oschmidh/ShiftLight-HW/ShiftLight.kicad_pcb

## KiCad design ShiftLight.kicad_pcb (2025-11-02)

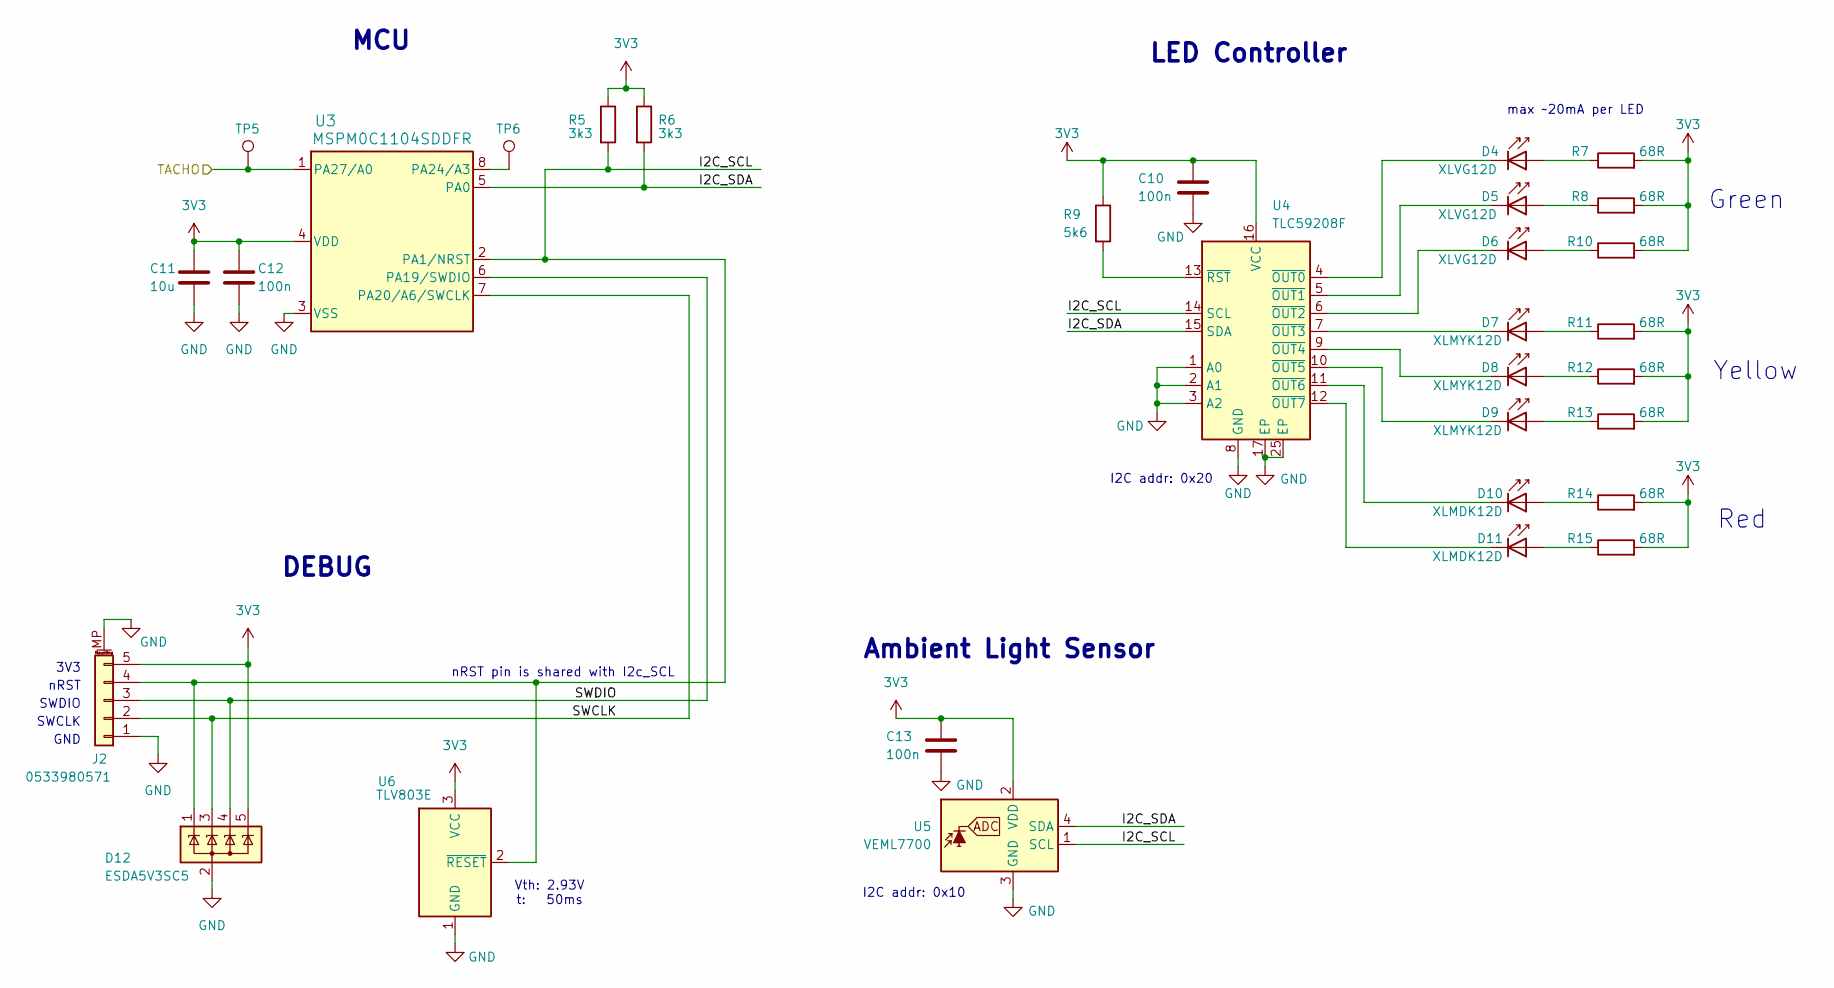
[picture p1: schematic 02_mcu.kicad_sch, ${PROJECTNAME}]

Parts:
C10, C12, C13: 100n; C_0402_1005Metric; MPN CL05B104KA5NNNC; DigiKey PN 1276-6720-1-ND
C11: 10u; C_1206_3216Metric; MPN CL31B106KAHNNNE; DigiKey PN 1276-1804-1-ND
D4, D5, D6: XLVG12D; LED_D5.0mm_IRGrey; MPN XLVG12D; DigiKey PN 1497-XLVG12D-ND
D7, D8, D9: XLMYK12D; LED_D5.0mm_IRGrey; MPN XLMYK12D; DigiKey PN XLMYK12D-ND
D10, D11: XLMDK12D; LED_D5.0mm_IRGrey; MPN XLMDK12D; DigiKey PN 1497-1354-ND
D12: ESDA5V3SC5; SOT-23-5; MPN ESDA5V3SC5; DigiKey PN 497-7746-1-ND
J2: 0533980571; Molex_PicoBlade_53398-0571_1x05-1MP_P1.25mm_Vertical; MPN 0533980571; DigiKey PN WM7609CT-ND
R5, R6: 3k3; R_0402_1005Metric; MPN RC0402FR-133K3L; DigiKey PN 13-RC0402FR-133K3LCT-ND
R7, R8, R10, R11, R12, R13, R14, R15: 68R; R_0402_1005Metric; MPN RC0402FR-0768RL; DigiKey PN 311-68.0LRCT-ND
R9: 5k6; R_0402_1005Metric; MPN RC0402FR-075K6L; DigiKey PN 311-5.6KLRCT-ND
TP5, TP6: TestPoint_Pad_D1.0mm
U3: MSPM0C1104SDDFR; SOT-23-8; MPN MSPM0C1104SDDFR; DigiKey PN 296-MSPM0C1104SDDFRCT-ND
U4: TLC59208F; Texas_RGY_R-PVQFN-N16_EP2.05x2.55mm_ThermalVias; MPN TLC59208FIRGYR; DigiKey PN 296-36989-1-ND
U5: VEML7700; Vishay_VEML7700; MPN VEML7700-TR; DigiKey PN VEML7700CT-ND
U6: TLV803E; SOT-23; MPN TLV803ED29DBZR; DigiKey PN 296-TLV803ED29DBZRCT-ND

Connections:
3V3: C10.1, C11.2, C12.1, C13.1, D12.5 (K), J2.5, R5.1, R6.1, R7.2, R8.2, R9.1, R10.2, R11.2, R12.2, R13.2, R14.2, R15.2, U3.4 (VDD), U4.16 (VCC), U5.2 (VDD), U6.3 (VCC); also elsewhere on the board
/01_Input/TACHO: TP5.1, U3.1 (PA27/A0); also elsewhere on the board
/02_MCU/I2C_SCL: D12.1 (K), J2.4, R5.2, U3.2 (PA1/NRST), U4.14 (SCL), U5.1 (SCL), U6.2 (~RESET)
/02_MCU/I2C_SDA: R6.2, U3.5 (PA0), U4.15 (SDA), U5.4 (SDA)
/02_MCU/SWCLK: D12.3 (K), J2.2, U3.7 (PA20/A6/SWCLK)
/02_MCU/SWDIO: D12.4 (K), J2.3, U3.6 (PA19/SWDIO)
GND: C10.2, C11.1, C12.2, C13.2, D12.2 (A), J2.1, J2.MP (MountPin), U3.3 (VSS), U4.1 (A0), U4.2 (A1), U4.3 (A2), U4.8 (GND), U4.17 (EP), U4.25 (EP), U5.3 (GND), U6.1 (GND); also elsewhere on the board
unnamed: D4.2 (A), R7.1
unnamed: D4.1 (K), U4.4 (~OUT0)
unnamed: D5.2 (A), R8.1
unnamed: D5.1 (K), U4.5 (~OUT1)
unnamed: D6.2 (A), R10.1
unnamed: D6.1 (K), U4.6 (~OUT2)
unnamed: D7.2 (A), R11.1
unnamed: D7.1 (K), U4.7 (~OUT3)
unnamed: D8.2 (A), R12.1
unnamed: D8.1 (K), U4.9 (~OUT4)
unnamed: D9.2 (A), R13.1
unnamed: D9.1 (K), U4.10 (~OUT5)
unnamed: D10.2 (A), R14.1
unnamed: D10.1 (K), U4.11 (~OUT6)
unnamed: D11.2 (A), R15.1
unnamed: D11.1 (K), U4.12 (~OUT7)
unnamed: TP6.1, U3.8 (PA24/A3)
unnamed: R9.2, U4.13 (~RST)

Notes on the sheet:
I2C addr: 0x20
I2C addr: 0x10
Green
Red
max ~20mA per LED
Ambient Light Sensor
nRST
MCU
SWCLK
3V3
nRST pin is shared with I2c_SCL
GND
Yellow
Vth: 2.93V t: 50ms
LED Controller
SWDIO
DEBUG

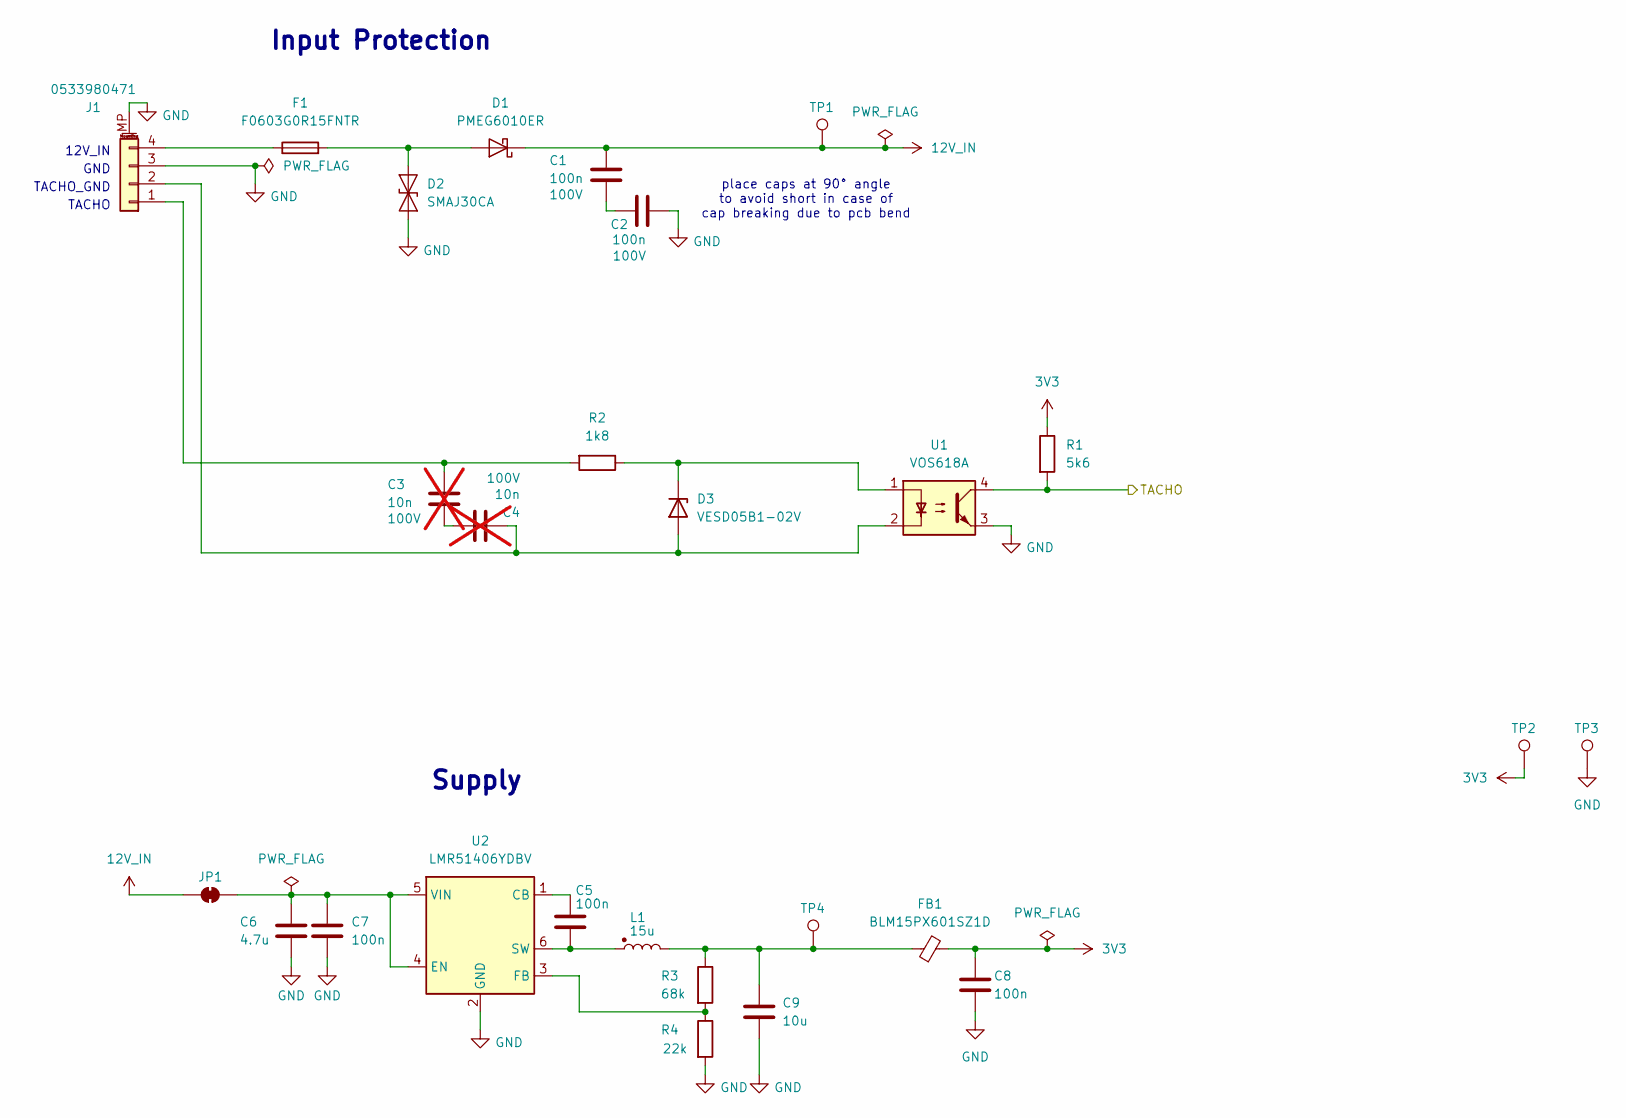
[picture p2: schematic 01_input.kicad_sch, ${PROJECTNAME}]

Parts:
C1, C2: 100n; C_0805_2012Metric; Voltage 100V; MPN CL21B104KCFWPNE; DigiKey PN 1276-6733-1-ND
C3, C4: 10n; C_0402_1005Metric; Voltage 100V; MPN HMK105B7103KVHFE; DigiKey PN 587-HMK105B7103KVHFECT-ND; not fitted
C5, C7, C8: 100n; C_0402_1005Metric; MPN CL05B104KA5NNNC; DigiKey PN 1276-6720-1-ND
C6: 4.7u; C_1206_3216Metric; MPN CL31B475KBHVPJE; DigiKey PN 1276-CL31B475KBHVPJECT-ND
C9: 10u; C_1206_3216Metric; MPN CL31B106KAHNNNE; DigiKey PN 1276-1804-1-ND
D1: PMEG6010ER; Nexperia_CFP3_SOD-123W; MPN PMEG6010ER,115; DigiKey PN 1727-5846-1-ND
D2: SMAJ30CA; D_SMA; MPN SMAJ30CA; DigiKey PN SMAJ30CALFCT-ND
D3: VESD05B1-02V; D_SOD-523; MPN VESD05B1-02V-G3-08; DigiKey PN VESD05B1-02V-G3-08GICT-ND
F1: F0603G0R15FNTR; Fuse_0603_1608Metric; MPN F0603G0R15FNTR; Mouser No 581-F0603G0R15FNTR
FB1: BLM15PX601SZ1D; L_0402_1005Metric; MPN BLM15PX601SZ1D; DigiKey PN 490-16655-1-ND
J1: 0533980471; Molex_PicoBlade_53398-0471_1x04-1MP_P1.25mm_Vertical; MPN 0533980471; DigiKey PN WM7608CT-ND
JP1: SolderJumper-2_P1.3mm_Bridged_RoundedPad1.0x1.5mm
L1: 15u; L_TDK_VLS3015CX; MPN VLS3015CX-150M-H; DigiKey PN 445-VLS3015CX-150M-HCT-ND
R1: 5k6; R_0402_1005Metric; MPN RC0402FR-075K6L; DigiKey PN 311-5.6KLRCT-ND
R2: 1k8; R_0402_1005Metric; MPN RC0402FR-071K8L; DigiKey PN 311-1.80KLRCT-ND
R3: 68k; R_0402_1005Metric; MPN RC0402FR-0768KL; DigiKey PN 311-68.0KLRCT-ND
R4: 22k; R_0402_1005Metric; MPN RC0402FR-0722KL; DigiKey PN 311-22.0KLRCT-ND
TP1, TP2, TP3, TP4: TestPoint_Pad_D1.0mm
U1: VOS618A; SSOP-4_4.4x2.6mm_P1.27mm; MPN VOS618A-3X001T; DigiKey PN VOS618A-3X001TCT-ND
U2: LMR51406YDBV; SOT-23-6; MPN LMR51406YDBV; DigiKey PN 296-LMR51406YDBVRCT-ND

Connections:
3V3: C8.1, FB1.2, R1.1, TP2.1; also elsewhere on the board
12V_IN: C1.1, D1.1 (K), JP1.1 (A), TP1.1
/01_Input/TACHO: R1.2, U1.4; also elsewhere on the board
GND: C2.2, C6.2, C7.2, C8.2, C9.1, D2.1 (A1), J1.3, J1.MP (MountPin), R4.2, TP3.1, U1.3, U2.2 (GND); also elsewhere on the board
unnamed: C1.2, C2.1
unnamed: C3.2, C4.1
unnamed: C9.2, FB1.1, L1.2, R3.1, TP4.1
unnamed: D1.2 (A), D2.2 (A2), F1.2
unnamed: C4.2, D3.2 (A), J1.2, U1.2
unnamed: D3.1 (K), R2.1, U1.1
unnamed: C3.1, J1.1, R2.2
unnamed: F1.1, J1.4
unnamed: C6.1, C7.1, JP1.2 (B), U2.4 (EN), U2.5 (VIN)
unnamed: C5.1, U2.1 (CB)
unnamed: R3.2, R4.1, U2.3 (FB)
unnamed: C5.2, L1.1, U2.6 (SW)

Notes on the sheet:
TACHO
Input Protection
Supply
place caps at 90° angle to avoid short in case of cap breaking due to pcb bend
12V_IN
GND
TACHO_GND

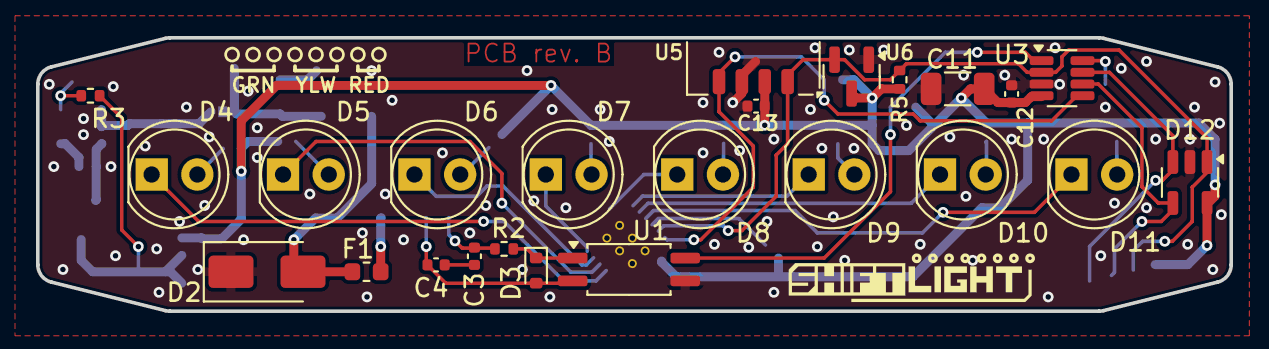
[picture p3: board ShiftLight.kicad_pcb from above]

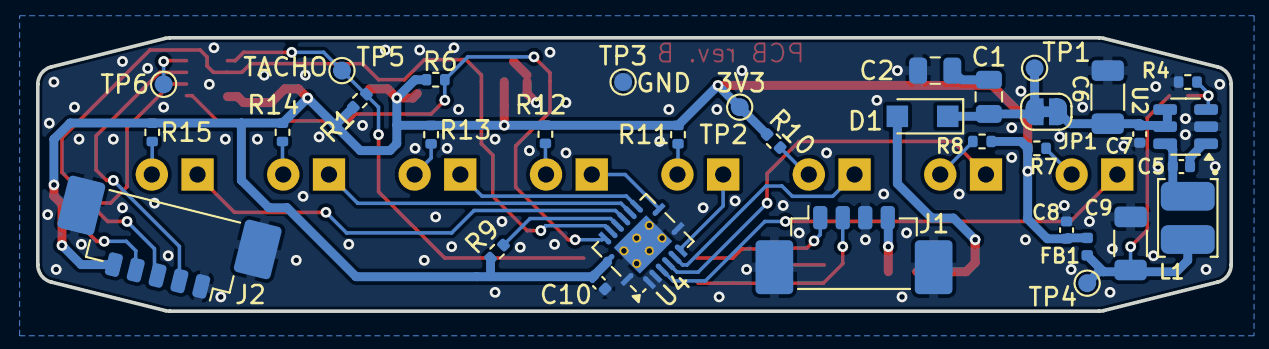
[picture p4: board ShiftLight.kicad_pcb from below]

Board: 2 copper layers, 66.3 x 15.2 mm, 58 parts (34 on the bottom side), 38 nets.
