oschmidh/ShiftLight-HW/(commit log)

2025-05-03 Setup project
    [ShiftLight.kicad_pcb, ShiftLight.kicad_sch]
2025-07-08 Update schematic, make hierarchical
    [01_input.kicad_sch, 02_mcu.kicad_sch, ShiftLight.kicad_sch]
2025-07-09 Schematic: Update, annotate
    [01_input.kicad_sch, 02_mcu.kicad_sch]
2025-07-09 Layout: Import, start placement
    [ShiftLight.kicad_pcb]
2025-07-14 Schematic: Adjust pinouts for easier routing
    [01_input.kicad_sch, 02_mcu.kicad_sch]
2025-07-14 Layout: Initial component placement
    [ShiftLight.kicad_pcb]
2025-07-22 Add personal library
    [01_input.kicad_sch, 02_mcu.kicad_sch]
2025-07-24 Schematic: Fix different 3V3 netnames, optimize pinouts
    [02_mcu.kicad_sch]
2025-07-24 Layout: Finish routing, start silkscreen cleanup
    [ShiftLight.kicad_pcb]
2025-07-24 Layout: Cleanup silkscreen and assembly drawing
    [ShiftLight.kicad_pcb]
2025-07-24 Layout: Update footprints to fix DRC errors
    [ShiftLight.kicad_pcb]
2025-07-24 Schematic: Add PWR_FLAGs to fix ERC errors
    [01_input.kicad_sch, 02_mcu.kicad_sch]
2025-07-24 Schematic: Remove nRST net label to avoid ERC warning
    [01_input.kicad_sch, 02_mcu.kicad_sch]
2025-07-24 Layout: Minor improvements
    [ShiftLight.kicad_pcb]
2025-07-24 Ci: Generate gerber files
2025-07-24 Ci: Fill title header in generated schematic
    [01_input.kicad_sch, 02_mcu.kicad_sch, ShiftLight.kicad_sch]
2025-07-24 Ci: Change BOM delimiter
2025-07-24 Ci: Use protel file extension for Gerberfiles
    This is preferred by JLCPCB
2025-07-24 Ci: Generate Drill files
2025-07-24 Schematic: Remove Testpoints from BOM
    [01_input.kicad_sch, 02_mcu.kicad_sch]
2025-07-29 Add MPN and DigiKey PN to all components
    [01_input.kicad_sch, 02_mcu.kicad_sch]
2025-07-29 Adjust BOM for ordering at DigiKey
2025-07-30 Layout: Minor cleanup
    [ShiftLight.kicad_pcb]
2025-11-02 Schematic: Update comments for I2c addresses of devices
    Fix incorrect address for LED driver and add address of ambient light
    sensor.
    [02_mcu.kicad_sch]
2025-11-02 Fix swapped SCL and SDA pins for VEML7700
    [02_mcu.kicad_sch, ShiftLight.kicad_pcb]
2025-11-02 Layout: Increment revision to B
    [ShiftLight.kicad_pcb]
2025-11-02 Fix wrong footprint for TLV803E
    [02_mcu.kicad_sch, ShiftLight.kicad_pcb]
